cxmmeg/InfraEye/Modelling/HandExample.jpg

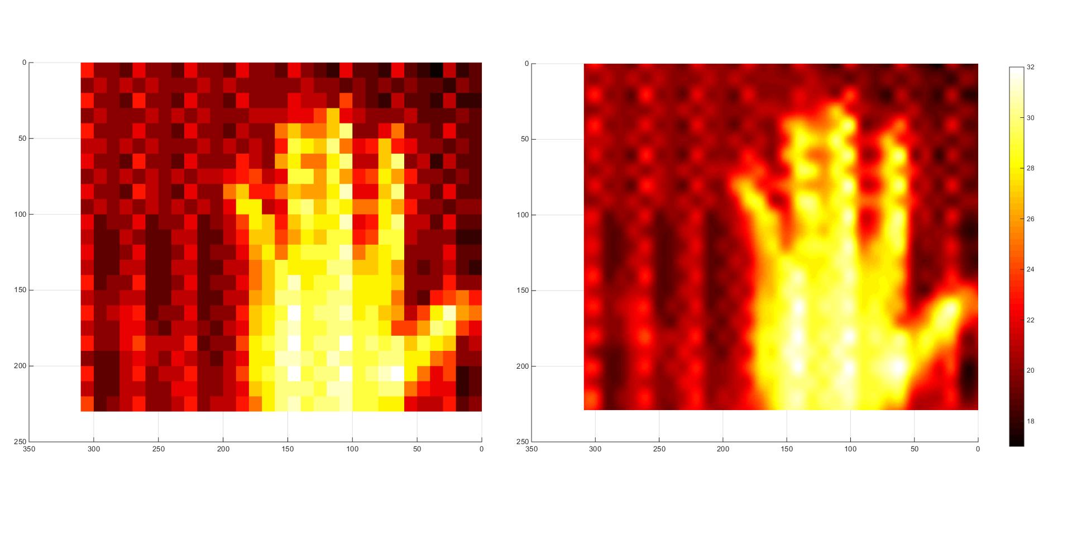
Modelling/HandExample.jpg
