cxmmeg/InfraEye/Software/InfraEye/main/image.jpg

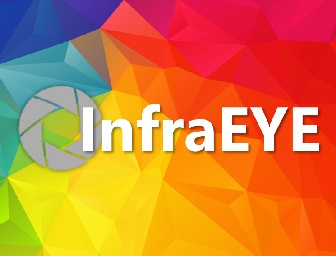
Software/InfraEye/main/image.jpg
