cxmmeg/InfraEye/README.md

# InfraEye
**InfraEye** is name for low cost thermal image camera project based on SoC ESP32. 

It uses IR sensor MLX90640B. Image can be viewed by default on web page on web server created by ESP32 or optionally on 2.4'' LCD touch display.
