cxmmeg/InfraEye/Hardware/README.md

PCB will have ESP8266, Infra sensor, micro USB conector, DC-DC inverter and LCD
