cxmmeg/InfraEye/Documents/Requirements/5_Enclosure.md

There will be 2 types of 3D printed enclosures:
1. for variant without display
2. for variant with display

Enclosure will have some kind of way to attach it to holder/battery/phone/notebook.
