cxmmeg/InfraEye/Documents/Requirements/4_Display.md

Device will have no display by default.
Optionaly it can have touch screen, which will display data from sensor.
https://www.aliexpress.com/item/240x320-2-4-SPI-TFT-LCD-Touch-Panel-Serial-Port-Module-With-PBC-ILI9341-3-3V/32832952750.html
