cxmmeg/InfraEye/Documents/Requirements/3_Processor.md

Processor ESP8266 with WIFI will be used as main processor.
It will provide its own WIFI network, to which client has to connect.
Processor will run web server with single web page, which will display image from sensor.
https://www.aliexpress.com/item/NodeMcu-Lua-WIFI-development-board-based-on-the-ESP8266-Internet-of-things/32443964726.html
