cxmmeg/InfraEye/Documents/Requirements/2_IR_sensor.md

IR sensor MLX90640B from company Melexis will be used.
It has resolution of 32x24 pixels nad viewing angle of 55°.
https://www.mouser.sk/datasheet/2/734/MLX90640-Datasheet-Melexis-1324357.pdf
