cxmmeg/InfraEye/Documents/Requirements/1_Power_supply.md

Infra sensor and ESP8266 have supply voltage 3,3V
Device will be powered from 5V micro USB cable (from computer, power bank, mobile phone charger, e.t.c.)
Step down DC-DC inverter will be used to create 3,3V
e.g.: https://www.aliexpress.com/item/High-Quality-5PCS-5V-to-3-3V-For-DC-DC-Step-Down-Power-Supply-Buck-Module/32774098119.html
