cxmmeg/InfraEye/Documents/Pinouts/Pinounts and connections.docx

# MLX90640 (IR sensor)

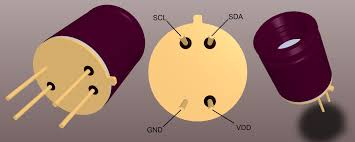
[picture p3: figure]

# ILI9341 (TFT LCD)

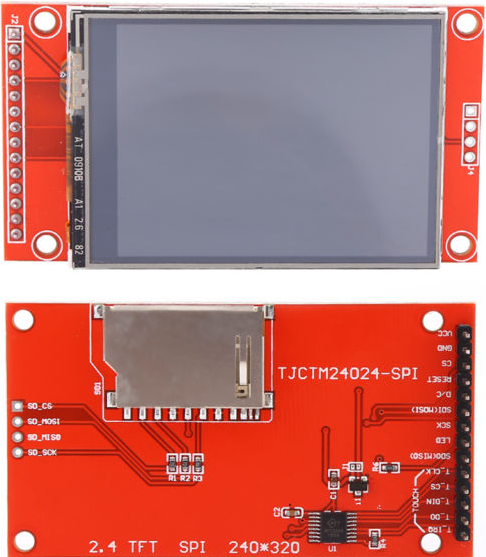
[picture p4: figure]

# NodeMCU (ESP8266)

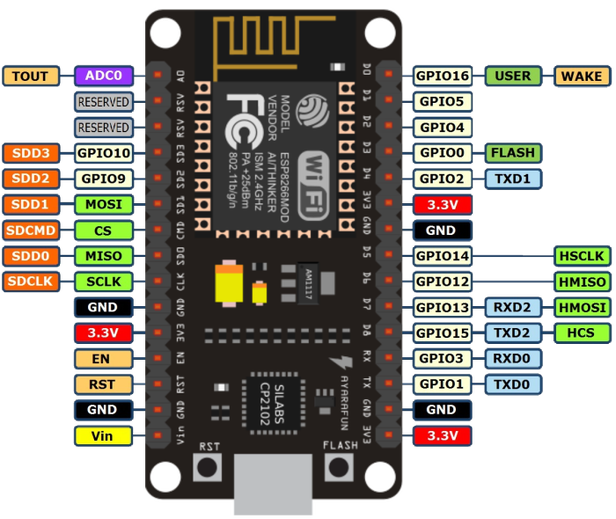
[picture p5: figure]

# ESP32 HELTEC

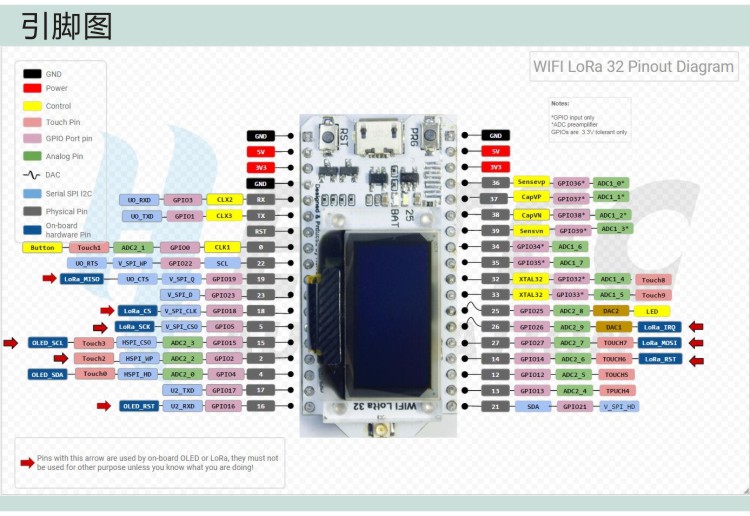
[picture p6: figure]
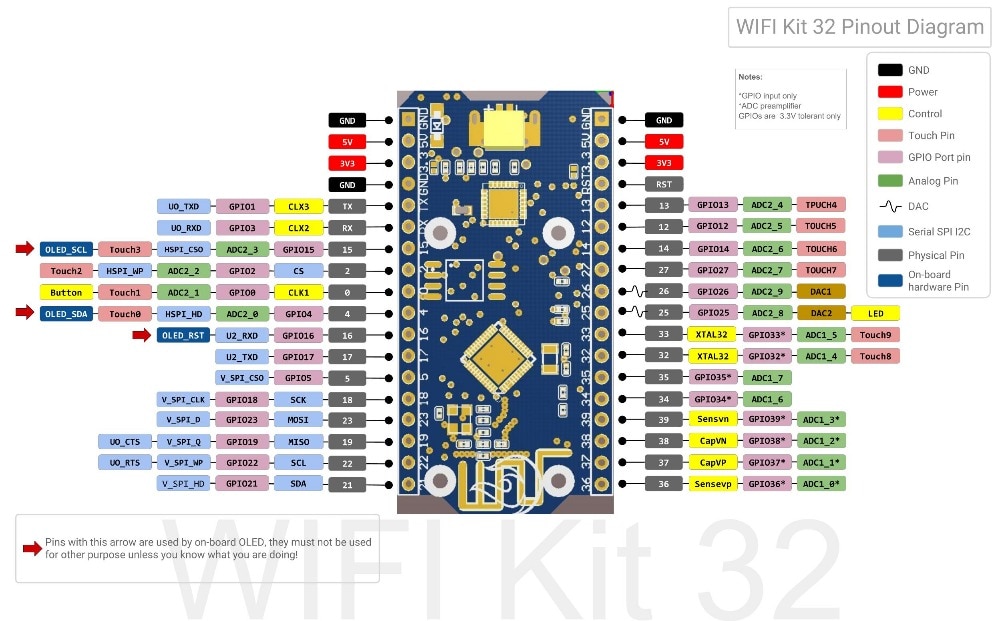
[picture p7: figure]
VÃ½sledok vyhÄ¾adÃ¡vania obrÃ¡zkov pre dopyt htit-wb32 pinout

# ESP-WROOM-32

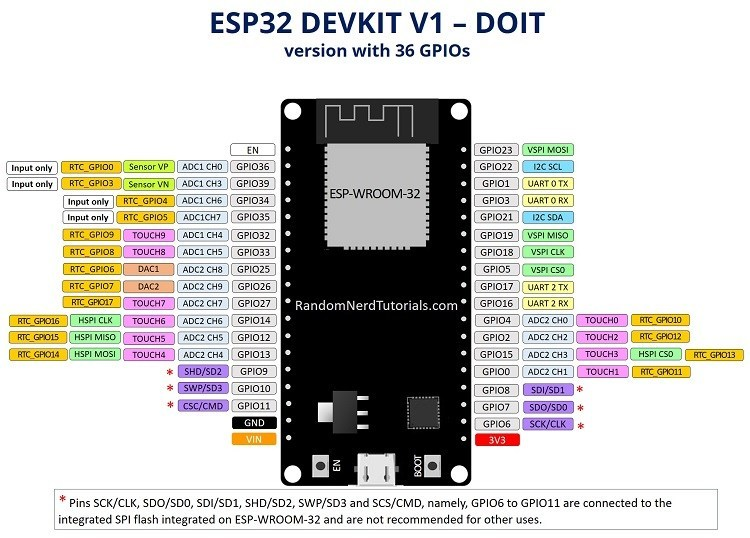
[picture p8: figure]
ESP32 DEVKIT V1 DOIT board with 36 pins Pinout
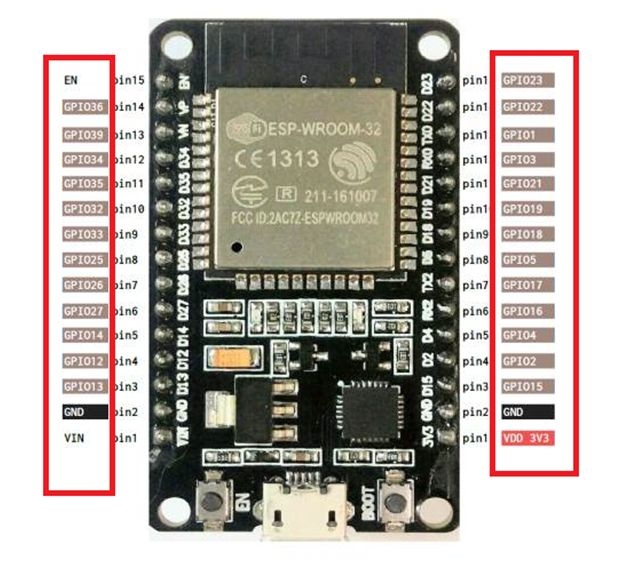
[picture p9: figure]
Výsledok vyhľadávania obrázkov pre dopyt ESP32-WROOM32 pinout

# TABLES

Connection of IR sensor:

| ESP8266 | ESP32
SCL | D1/GPIO5 | GPIO22
SDA | D2/GPIO4 | GPIO21

Connection of LCD:

LCD | | NodeMCU | | ESP32 | | Notes
pin | Name | | GPIO | | GPIO
1 | VCC | 3,3/5V | - | | -
2 | GND | GND | - | | -
3 | CS | D8 | 0 | | 22
4 | RESET | RESET/3,3V | - | | 18 | RESET of NodeMCU or 3,3V or some GPIO if needed
5 | DC | D9/D4 | 2 | | 21
6 | MOSI | MOSI/D7 | 13 | | 23
7 | SCK | D5/SCK | 14 | | 19
8 | LED | 3,3/5V cez R | - | | -
9 | MISO | D6/NC | 12 | | 25 | Optional – needed only if read from LCD is needed

Connection of touch sensor:

Connection of SD card reader:
