cxmmeg/InfraEye/Modelling/CandleExample.jpg

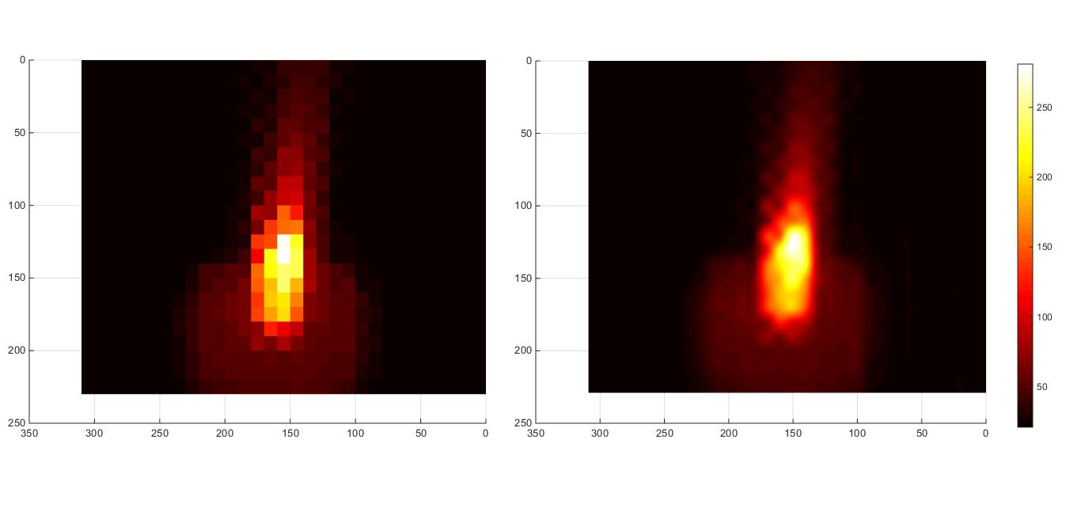
Modelling/CandleExample.jpg
