cxmmeg/InfraEye/Hardware/InfraEye/InfraEye.kicad_pcb

## KiCad design Hardware/InfraEye/InfraEye.kicad_pcb (2020-02-16)

Schematic: InfraEye.sch

Parts:
C1, C3: 10nF; C_1206_5MIL_DWS_ISO
C2, C4: 100nF; C_1206_5MIL_DWS_ISO
C5, C6: CP; C_Radial_D5.0mm_H11.0mm_P2.00mm
D1, D2, D3, D4: D; D_1206_3216Metric
D5: D_Zener; D_1206_3216Metric
J1: Conn_01x03_Male; FanPinHeader_1x03_P2.54mm_Vertical
Q1: Q_NPN_BCE; SOT23-3
R1, R2: R; R_1206_5MIL_DWS_ISO
R3: R; R_1206_3216Metric
U1, U4: MLX90640; MLX90614
U2: ESP32-WROOM-32; ESP32-WROOM-32-30pin
U3: TFT_SPI_24_LCD; TFT_LCD_24
U5: LT1129-3.3_SOT223; SOT-223-3_TabPin2

Connections:
+3V3: C1.1, C2.1, C3.1, C4.1, Q1.2 (C), R3.2, U1.2 (VDD), U2.16, U3.1 (VCC), U4.2 (VDD)
+5V: C6.1, U2.1, U5.3
GND: C1.2, C2.2, C3.2, C4.2, C5.2, C6.2, D3.2, D4.1, D5.2, U1.3 (GND), U2.2, U2.17, U3.2 (GND), U4.3 (GND), U5.2
unnamed: C5.1, D1.1, D2.2, D5.1, U5.1
unnamed: D1.2, D3.1, J1.1
unnamed: D2.1, D4.2, J1.2
unnamed: Q1.1 (B), R1.1
unnamed: Q1.3 (E), R2.1
unnamed: R1.2, U2.26
unnamed: R2.2, R3.1, U3.8 (LEDD)
unnamed: U1.1 (SDA), U2.30, U4.1 (SDA)
unnamed: U1.4 (SCL), U2.29, U4.4 (SCL)
unnamed: U2.3, U3.14 (IRQT)
unnamed: U2.4, U3.11 (CST)
unnamed: U2.8, U3.10 (CLKT), U3.18 (SCKC)
unnamed: U2.9, U3.12 (MOSIT), U3.17 (MISOC)
unnamed: U2.10, U3.13 (MISO), U3.16 (MOSIC)
unnamed: U2.11, U3.9 (MISOD)
unnamed: U2.12, U3.15 (CSC)
unnamed: U2.18, U3.3 (CSD)
unnamed: U2.20, U3.4 (RSTD)
unnamed: U2.23, U3.5 (DCD)
unnamed: U2.24, U3.6 (MOSID)
unnamed: U2.25, U3.7 (SCKD)

Notes on the sheet:
Component placement legend: B - Basic components - always populated W - WIFI version L - LCD version A - AC power supply R - Relay O - LCD backlight always on
Power supply

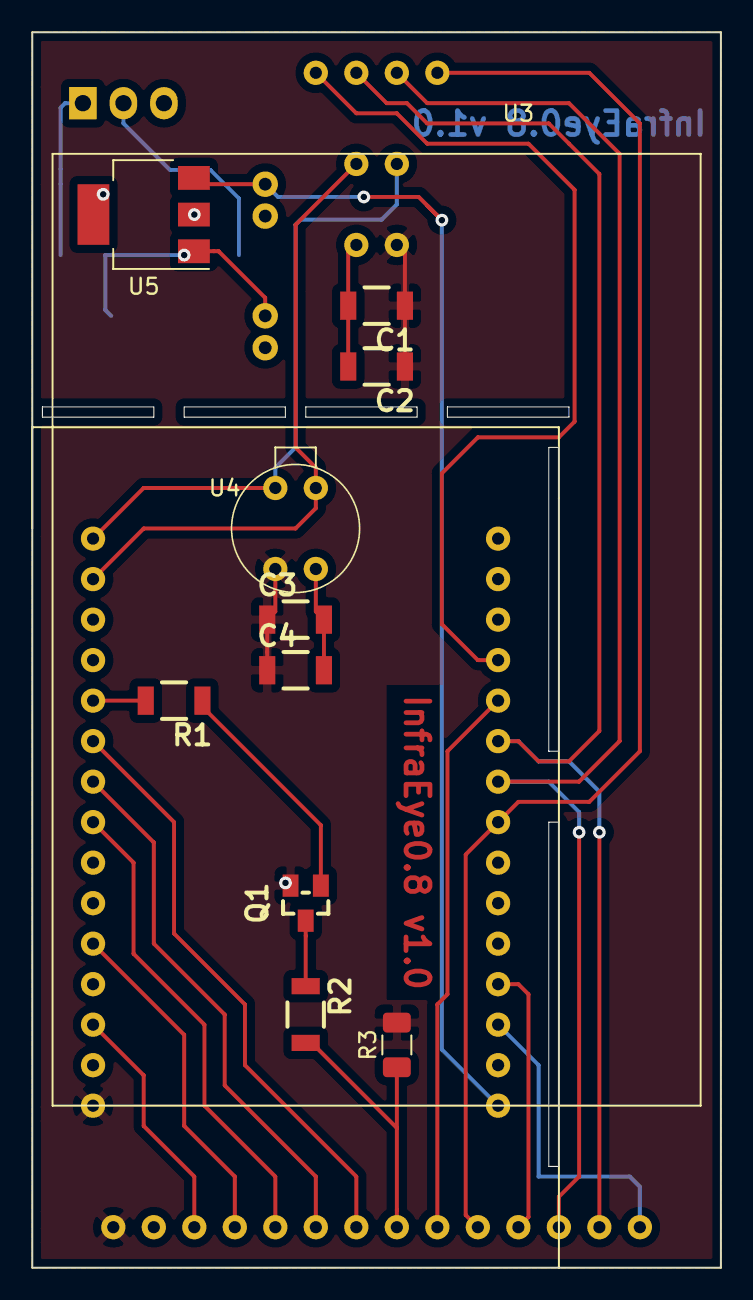
[picture p11: board InfraEye.kicad_pcb from above]

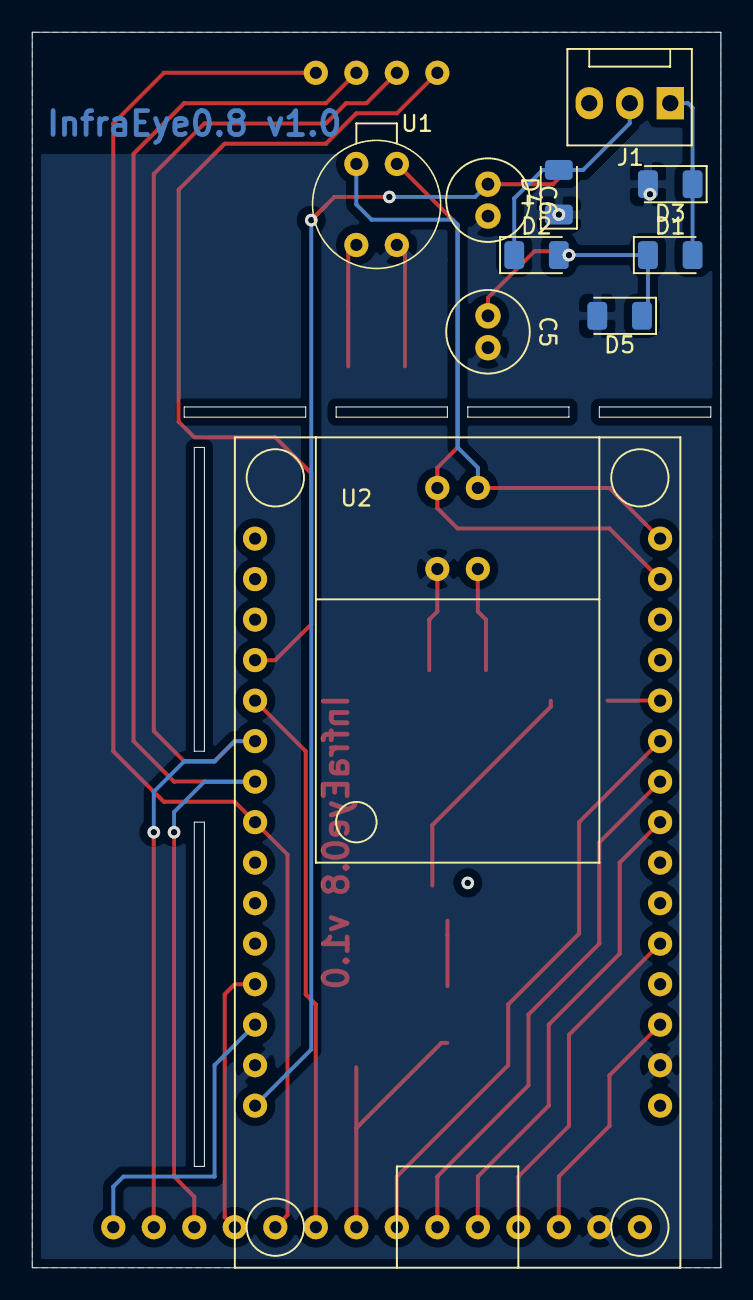
[picture p12: board InfraEye.kicad_pcb from below]

Board: 2 copper layers, 43.2 x 77.5 mm, 21 parts (10 on the bottom side), 24 nets.
