cxmmeg/InfraEye/Software/InfraEye/main/MLX90640_I2C_Driver.h

#include <stdint.h>
#include "driver/i2c.h"
/**
 * @copyright (C) 2017 Melexis N.V.
 *
 * Licensed under the Apache License, Version 2.0 (the "License");
 * you may not use this file except in compliance with the License.
 * You may obtain a copy of the License at
 *
 *     http://www.apache.org/licenses/LICENSE-2.0
 *
 * Unless required by applicable law or agreed to in writing, software
 * distributed under the License is distributed on an "AS IS" BASIS,
 * WITHOUT WARRANTIES OR CONDITIONS OF ANY KIND, either express or implied.
 * See the License for the specific language governing permissions and
 * limitations under the License.
 *
 */
#ifndef _MLX90640_I2C_Driver_H_
#define _MLX90640_I2C_Driver_H_

#define ACK_CHECK_EN 0x1                        /*!< I2C master will check ack from slave*/
#define ACK_CHECK_DIS 0x0                       /*!< I2C master will not check ack from slave */

#define _I2C_NUMBER(num) I2C_NUM_##num
#define I2C_NUMBER(num) _I2C_NUMBER(num)
#define I2C_MASTER_NUM I2C_NUMBER(0) /*!< I2C port number for master dev */

#define MLX90640_I2C_DRIVER_MODULE_SEND_MSG_ENABLED		0

    void MLX90640_I2CInit(void);
    int MLX90640_I2CRead(uint8_t slaveAddr,uint16_t startAddress, uint16_t nMemAddressRead, uint16_t *data);
    int MLX90640_I2CWrite(uint8_t slaveAddr,uint16_t writeAddress, uint16_t data);
    void MLX90640_I2CFreqSet(int freq);
#endif
