cxmmeg/InfraEye/(commit log)

2019-02-10 First draft of Arduino source with I2C communication with IR sensor working
2019-02-10 Fixed problem with buffer length of I2C
    Arduino Wire library is using 32 byte buffer, therefore transaction longer than 32 bytes of usefull data is not possible. Modified to read in chunks not longer tan 32 bytes.
    Added reading of frame from IR sensor. Conversion to temperature added too, but not functional yet.
2019-02-10 Fixed error in I2C driver
    When more than 32 bytes was requested to be read, repeatedly first 32 bytes was read, address was not modified.
2019-02-10 Temperature reading of all pixels implemented
    Both subpages are read now, which allows for calculation of temperatures for all pixels. Correct timing has to be determined as frame rate is currently very low.
2019-02-11 Upscaling algorithm for output data from sensor created in MATLAB.
2019-02-11 Changed mapping of pins so both IR sensor and LCD work together
2019-02-15 Improved frame rate to 4FPS
    Changed pattern to interleaved, so only changed pixels can be read efficiently.
    Also only changed pixels are overwritten on LCD.
2019-02-18 Added LIVE_DATA flag
    LIVE_DATA not defined means that temperatures are not taken from IR sensor, but from static array
2019-02-19 Picture is created only once per full frame
    Due to long calculation times, subPages get lost and picture is distorted.
2019-02-19 GetFrame time reduced by 10ms
    Time reduced from 42ms to 31ms by reading only current subPage.
2019-02-20 Fixed error in GetFrameData
    Error with missing subPages still missing.
    GetFrame now takes 22ms instead of original 42ms
    [MLX90640_API.h]
2019-02-21 Fixed problem with loosing subPage 0
    Real FPS is 1 now.
    Changed algorithm to make sure no subPage is lost.
    Image processing is terminated when new subPage is ready for reading resulting in partial image in case that FPS of sensor is too high.
2019-02-21 Image processing is executed during both subPages
    Real FPS is 2
    No buffer is used to make sure that single complete frame is displayed. It is visible.
2019-02-21 Full image is always drawn
    If image processing takes longer than whole frame measurement, image processing is carried out during next frame measurement.
2019-02-22 Added refresh rate of IR sensor into config file
2019-02-24 Changed temperatures from float to uint16_t
2019-02-24 Fixed point upscaling algorithm updated. Displaying is not correct - need to be fixed.
    [module_IRsensor.h, module_ImageUpscaling.h]
2019-02-27 Fixed LIVE_DATA macro, updated documentation - ESP32 added
    [config.h]
2019-04-08 Update Pinounts and connections.docx
    Added pinouts for ESP32 and LCD
2019-04-18 Arduino project deleted from master branch. Arduino source code can be found in dev_arduino branch. New ESP-IDF Toolchain LED blinking application added into master branch.
2019-05-11 Frequency switched to 240 MHz Moving rectangle application created.
2019-05-12 Added two tasks. One is currently used just for debugging and the other one makes recalculation for display. In main (idle task) LCD is updated.
2019-05-12 FPS calculation added, not sure if it's calculated correctly.
    [app_main.c]
2019-06-23 For MLX90640 IR sensor added: driver and I2C driver. I2C not working yet.
    [MLX90640_API.c, MLX90640_API.h, MLX90640_I2C_Driver.c, MLX90640_I2C_Driver.h, app_main.c, config.h, module_IRsensor.c, module_IRsensor.h]
2019-06-30 I2C driver is initialized and installed. i2c_master_cmd_begin() returns -1 - general I2C error, therefore I2C scan fails.
    [MLX90640_I2C_Driver.c, MLX90640_I2C_Driver.h, app_main.c, module_IRsensor.c, module_IRsensor.h]
2019-07-01 I2C scan now finds IR sensor, but timeout is detected ESP_ERR_TIMEOUT 0x107 /*!< Operation timed out */
2019-07-01 I2C scan now finds IR sensor correctly
    [module_IRsensor.c]
2019-07-03 I2C read function rewritten from "Arduino to esp_idf", not yet verified if correctly.
    [MLX90640_I2C_Driver.c]
2019-07-27 Display colour setting fixed.
    [app_display.c, app_display.h, app_main.c]
2019-07-27 Colour is set according to I2C status.
2019-08-26 Updated I2C write. Something is still correct. Value that is read out doesn't match the one that was written. At this point it is not clear if it is issue of reading or writing. Logical analyzator co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
    [MLX90640_API.c, MLX90640_I2C_Driver.c, module_IRsensor.c]
2019-08-27 I2C reading was not correct, repeated start was not present. Both reading and writing seems to be working correctly. Cleanup is needed and debug messages needs to be removed/commented out.
    [MLX90640_I2C_Driver.c, module_IRsensor.c]
2019-08-28 When using i2c_master_read() MSB, LSB are swapped in every word. When using i2c_master_read_byte() correct order can be selected, but there are delays between bytes read out. For performance purposes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
    [MLX90640_I2C_Driver.c]
2019-08-28 Reading of more than single word seems to be correct, but reading many words at once triggers task watchdog.
    [MLX90640_I2C_Driver.c, module_IRsensor.c]
2019-08-29 When added global u16_pixelValue[768], malloc in app_disp_vInitialize() fails to allocate memory.
    [app_main.c]
2019-11-23 Read from IR sensor fixed. Temperature calculation added
    [MLX90640_API.c, MLX90640_API.h, MLX90640_I2C_Driver.c, MLX90640_I2C_Driver.h, app_display.c, app_display.h, app_main.c, config.h]
2020-01-13 Fixed error in coordinate calculation for drawing image from sensor to LCD. Added LSB/MSB switch operation when temperature is converted to color. Fixed color enumerators. Added set pixel function fo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
    Measured data from sensor is displayed on LCD in 300% scale (no filtering, just pixel is 3x3 big).
    FPS is not measured, but is pretty good.
    [app_display.c, app_display.h, app_main.c, module_IRsensor.c]
2020-01-15 Added empty module for touchscreen and driver for touchscreen chip XPT2046. Driver needs to be reworked as it is written for different platform.
    [XPT2046.c, XPT2046.h, app_main.c, module_TouchScreen.c]
2020-01-23 Added sources for LCD touch sensor chip (not working currently) Added fixes to sensor reading done by Martin.
    [MLX90640_API.c, MLX90640_API.h, MLX90640_I2C_Driver.c, MLX90640_I2C_Driver.h, XPT2046.c, XPT2046.h, app_display.c, app_display.h]
2020-01-25 Added footprints for LCD, ESP32 board and IR sensor
    [InfraEye.kicad_pcb, InfraEye.sch]
2020-01-25 Added footprints
2020-01-25 Fixed footprint for IR sensor (pins were mirrored as if sensor was mounted on other side of PCB)
    [InfraEye.kicad_pcb]
2020-01-29 Documentation: Updated pictures for ESP32 pinout.
    Configuration:
    SPI pin configuration moved to config.h file.
    Touch:
    Touch sensor moved to second SPI bus (on the same bus as LCD previously), but it's still dissabled as it is causing stability issues.
    Touch sensor reading is working (some data reading from touch chip is working, it reacts to touch, but coordinates are not parsed yet) on LCD SPI bus with LCD disabled (now LCD and touch cannot work on one bus).
    [app_display.c, app_display.h, app_main.c, config.h]
2020-01-29 Some pins for touch SPI were in conflict with hardcoded debug pins 26 and 25, so touch SPI pins were moved. It solved stability issue with enabled touch SPI bus initialization.
    Debug pins were temporarily disabled.
    Both LCD and Touch SPI buses are initialized and utilized, LCD works, however no data are coming from touch chip currently.
    [app_display.c, app_main.c, config.h]
2020-02-01 PCB: Added second IR sensor - LCD/WIFI version will have IR sensor placed on different places of PCB. SW: Changed pins of SPI buses, LCD moved to VSPI bus and speed increased to 60MHz, touch sensor m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
    [InfraEye.kicad_pcb, InfraEye.sch]
2020-02-06 Reworked schematics and PCB - signals moved around to minimize signal crossings - not verified on HW if it works with remapped signals as on schematics.
    [InfraEye.kicad_pcb, InfraEye.sch]
2020-02-15 Updated PCB - added text, finished track routing and fill areas. After verifying that it works as it is on schematics, it will be sent out for review.
    [InfraEye.kicad_pcb]
2020-02-16 Swapped I2C lines for better trace routing Further improvemets to board, added holes for easier board separation.
    [InfraEye.kicad_pcb, InfraEye.sch]
2020-02-16 Added AC power supply
    [InfraEye.sch]
2020-02-16 AC power supply added also to PCB
    [InfraEye.kicad_pcb, InfraEye.sch]
